mangkoran/lumberjack-keyboard/images/pcb-design.png

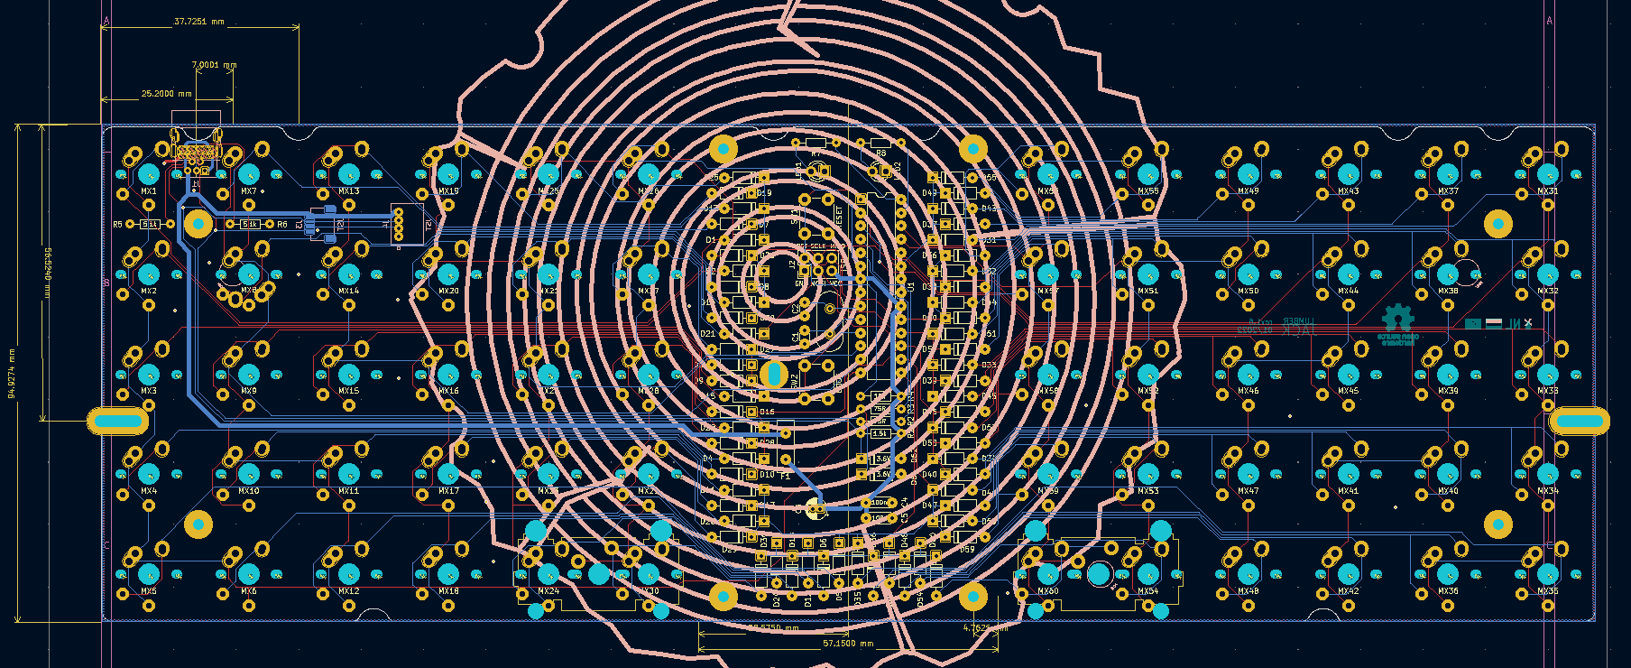
images/pcb-design.png
