mangkoran/lumberjack-keyboard/images/pcb-render.jpg

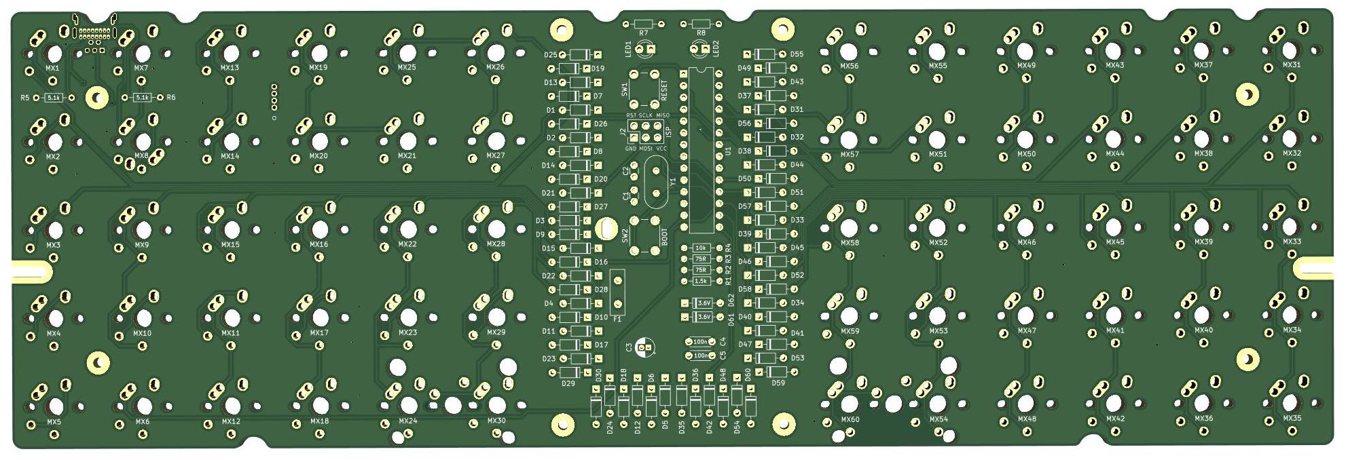
images/pcb-render.jpg
