mangkoran/lumberjack-keyboard/plates/lumberjack-brutal60-full.dxf

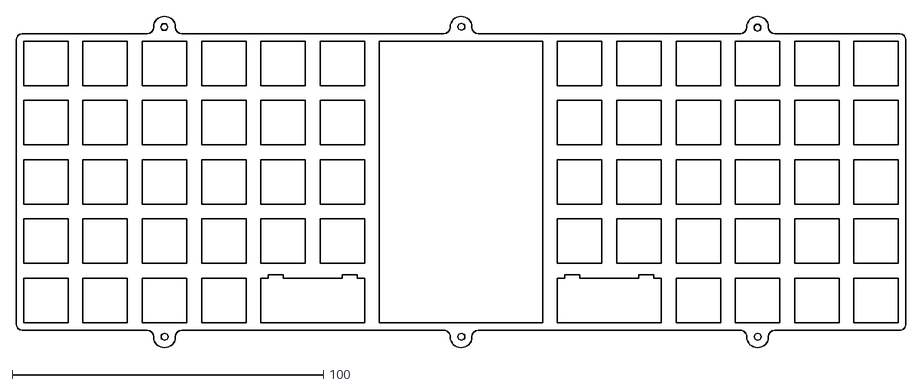
[picture p4: CAD file, 2022-01-30]
plates/lumberjack-brutal60-full.dxf
285.8 x 106.4
