mangkoran/lumberjack-keyboard/plates/lumberjack-full.dxf

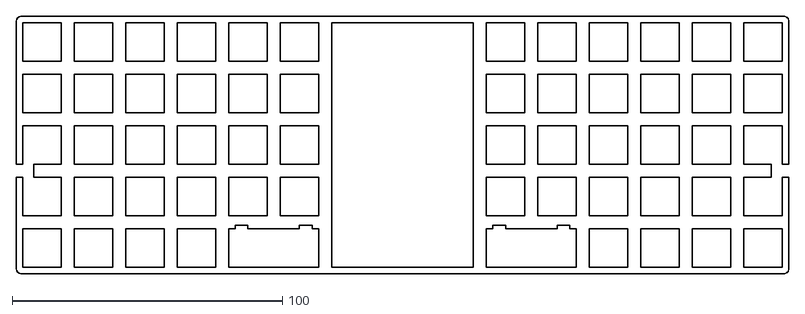
[picture p5: CAD file, 2022-01-30]
plates/lumberjack-full.dxf
285.8 x 95.3
