mangkoran/lumberjack-keyboard/plates/lumberjack-alps-full.dxf

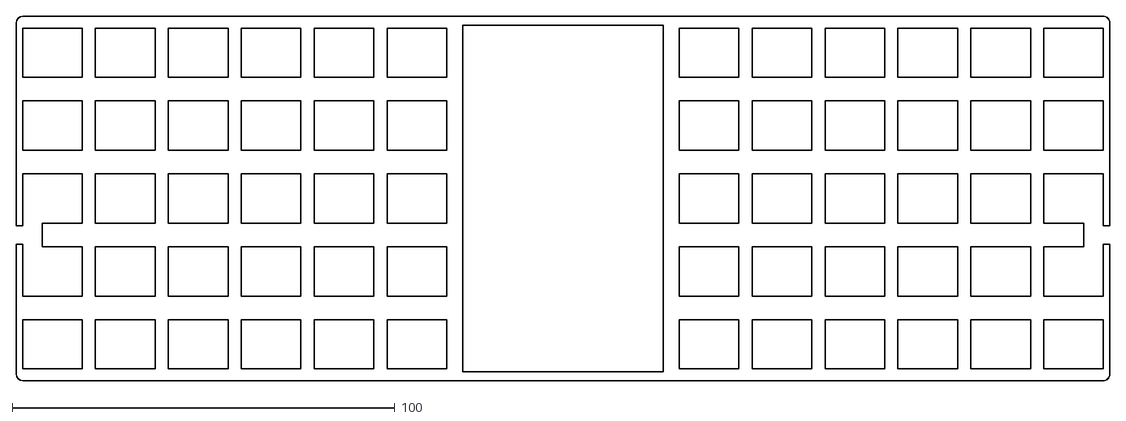
[picture p6: CAD file, 2022-01-30]
plates/lumberjack-alps-full.dxf
285.8 x 95.3
