mangkoran/lumberjack-keyboard/plates/lumberjack-polaris.dxf

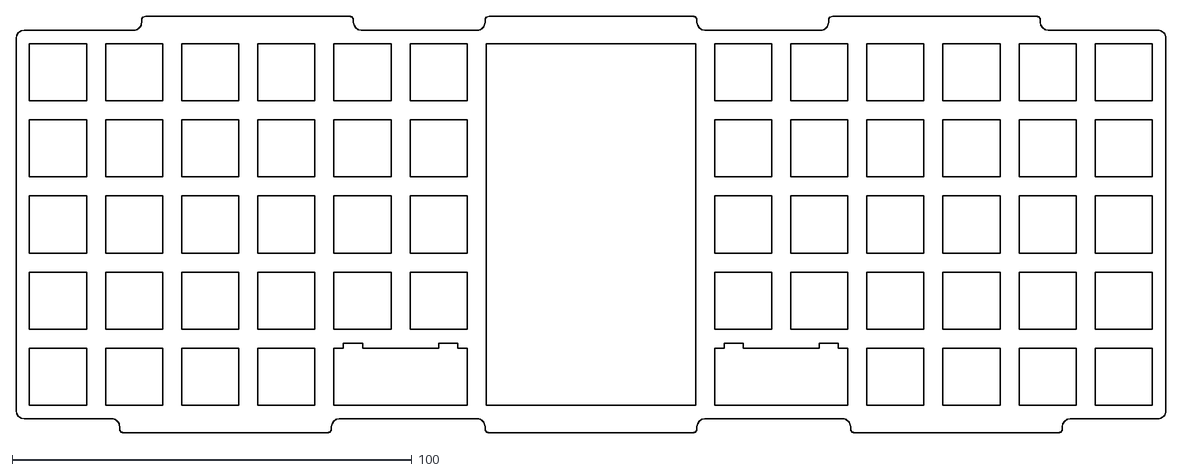
[picture p7: CAD file, 2022-01-30]
plates/lumberjack-polaris.dxf
287.7 x 104.2
