mangkoran/lumberjack-keyboard/plates/lumberjack-brutal60-split.dxf

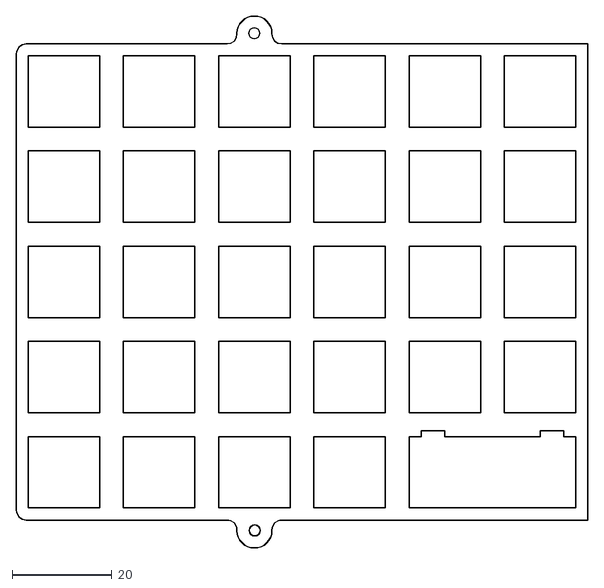
[picture p8: CAD file, 2022-01-30]
plates/lumberjack-brutal60-split.dxf
114.3 x 106.4
