mangkoran/lumberjack-keyboard/plates/lumberjack-alps-split.dxf

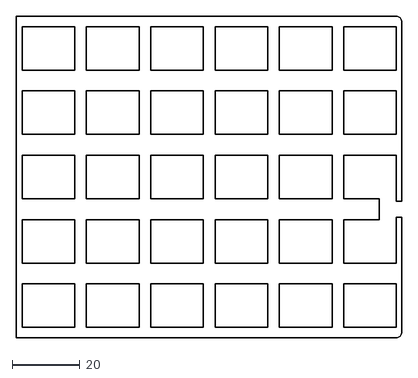
[picture p9: CAD file, 2022-01-18]
plates/lumberjack-alps-split.dxf
114.3 x 95.2
