mangkoran/lumberjack-keyboard/lumberjack.kicad_sch

## KiCad design lumberjack.kicad_sch (2022-02-06)

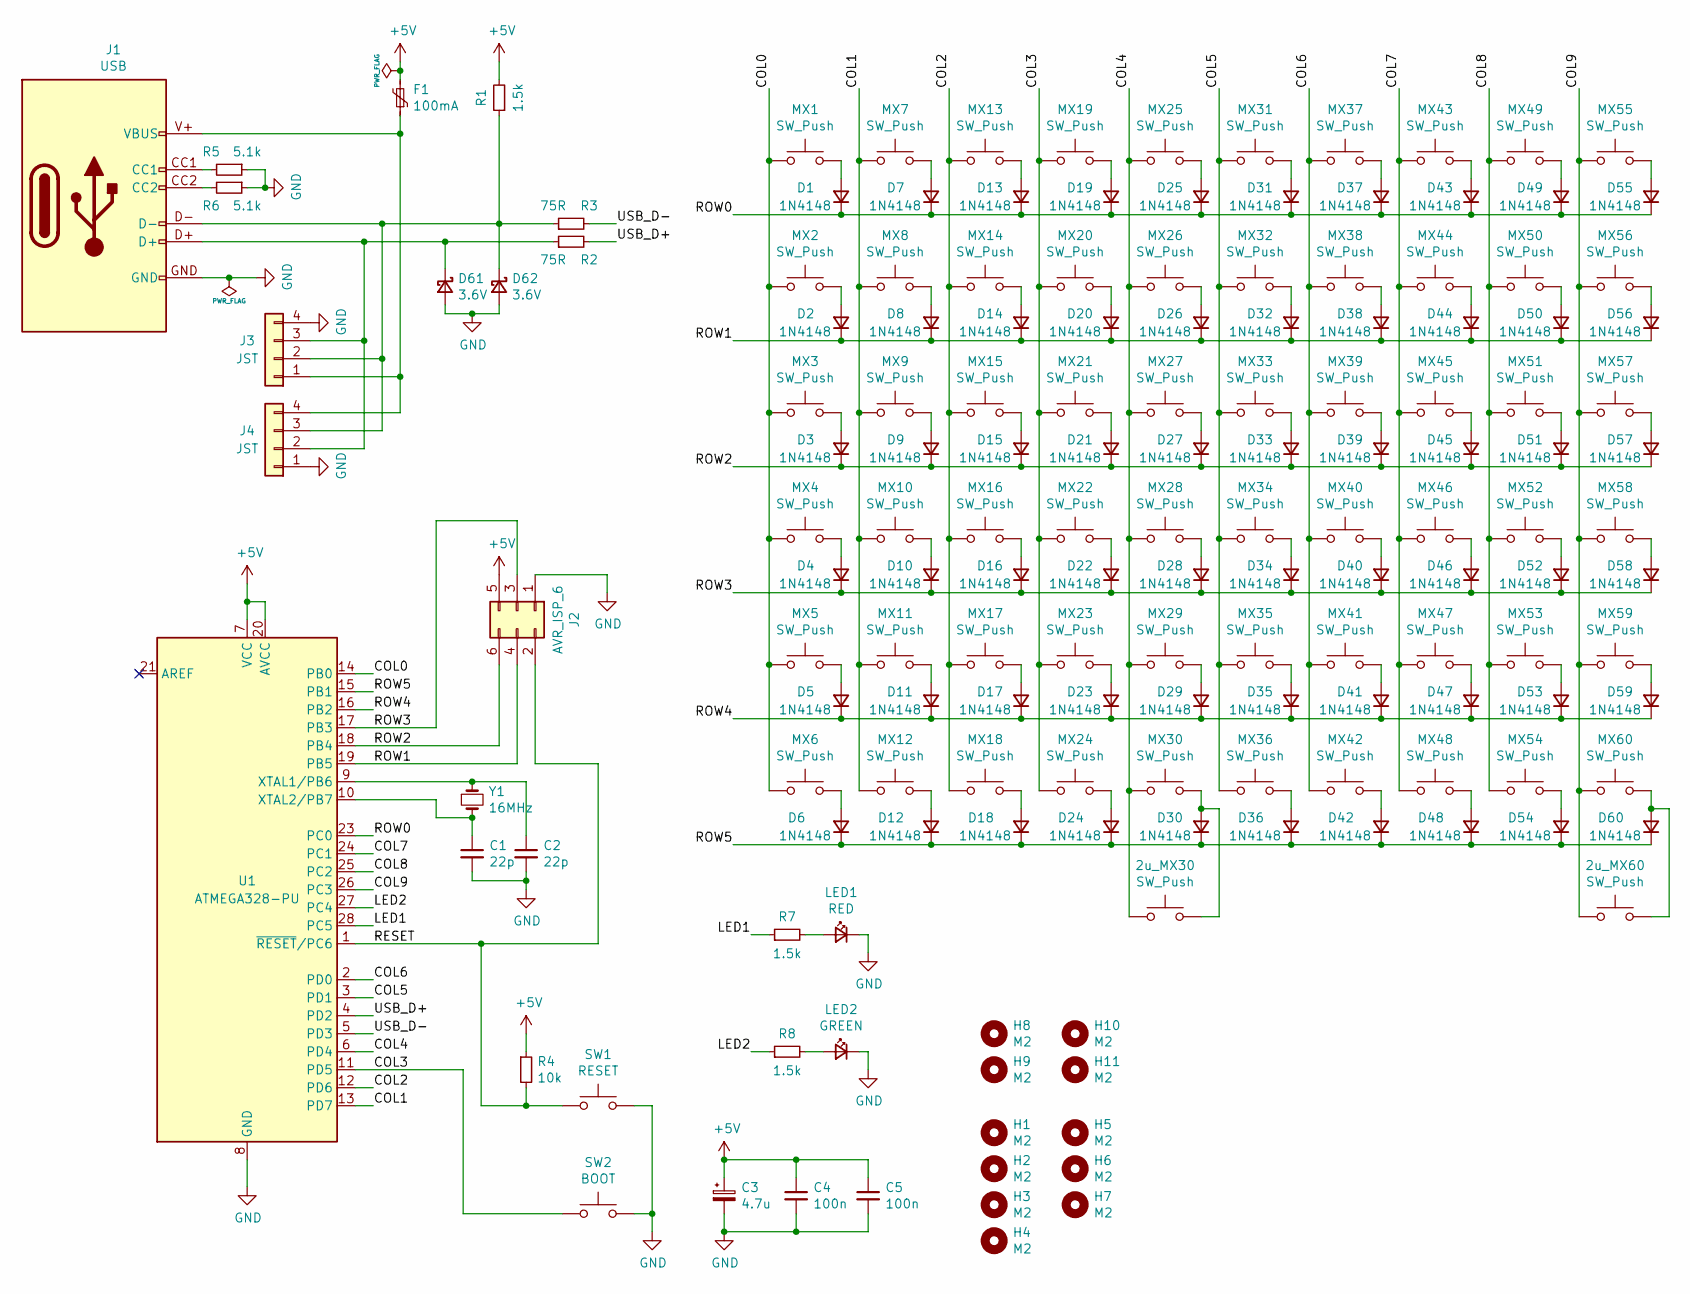
[picture p10: schematic lumberjack.kicad_sch]

Parts:
2u_MX30, 2u_MX60: SW_Push; MX_PCB_200B
C1, C2: 22p; C_Disc_D3.0mm_W1.6mm_P2.50mm
C3: 4.7u; CP_Radial_D4.0mm_P1.50mm
C4, C5: 100n; C_Disc_D4.3mm_W1.9mm_P5.00mm
D1, D2, D3, D4, D5, D6, D7, D8, D9, D10, D11, D12, D13, D14, D15, D16, D17, D18, D19, D20, D21, D22, D23, D24, D25, D26, D27, D28, D29, D30, D31, D32, D33, D34, D35, D36, D37, D38, D39, D40, D41, D42, D43, D44, D45, D46, D47, D48, D49, D50, D51, D52, D53, D54, D55, D56, D57, D58, D59, D60: 1N4148; D_DO-35_SOD27_P7.62mm_Horizontal
D61, D62: 3.6V; D_DO-35_SOD27_P7.62mm_Horizontal
F1: 100mA; Fuse_Bourns_MF-RHT100
H1, H2, H3, H4, H8, H9, H10, H11: M2; MountingHole_M2
H5, H6, H7: M2; MountingSlot_M2
J1: USB; USB_Hybrid_THT
J2: AVR_ISP_6; PinHeader_2x03_P2.54mm_Vertical
J3: JST; JST_SH_SM04B-SRSS-TB_1x04-1MP_P1.00mm_Horizontal
J4: JST; S4B-ZRLFSN
LED1: RED; LED_D3.0mm
LED2: GREEN; LED_D3.0mm
MX1, MX2, MX3, MX4, MX5, MX6, MX7, MX9, MX10, MX11, MX12, MX13, MX14, MX15, MX16, MX17, MX18, MX19, MX20, MX21, MX22, MX23, MX24, MX25, MX26, MX27, MX28, MX29, MX30, MX31, MX32, MX33, MX34, MX35, MX36, MX37, MX38, MX39, MX40, MX41, MX42, MX43, MX44, MX45, MX46, MX47, MX48, MX49, MX50, MX51, MX52, MX53, MX54, MX55, MX56, MX57, MX58, MX59, MX60: SW_Push; MX_Alps_Choc
MX8: SW_Push; MX_Alps_Choc_NTHSTH
R1, R7, R8: 1.5k; R_Axial_DIN0204_L3.6mm_D1.6mm_P7.62mm_Horizontal
R2, R3: 75R; R_Axial_DIN0204_L3.6mm_D1.6mm_P7.62mm_Horizontal
R4: 10k; R_Axial_DIN0204_L3.6mm_D1.6mm_P7.62mm_Horizontal
R5, R6: 5.1k; R_Axial_DIN0204_L3.6mm_D1.6mm_P7.62mm_Horizontal
SW1: RESET; SW_PUSH_6mm
SW2: BOOT; SW_PUSH_6mm
U1: ATMEGA328-PU; DIP-28_W7.62mm
Y1: 16MHz; Crystal_HC49-4H_Vertical

Connections:
+5V: C3.1, C4.1, C5.1, F1.2, J2.5, R1.2, R4.1, U1.7 (VCC), U1.20 (AVCC)
COL0: MX1.2, MX2.2, MX3.2, MX4.2, MX5.2, MX6.2, U1.14 (PB0)
COL1: MX7.2, MX8.2, MX9.2, MX10.2, MX11.2, MX12.2, U1.13 (PD7)
COL2: MX13.2, MX14.2, MX15.2, MX16.2, MX17.2, MX18.2, U1.12 (PD6)
COL3: MX19.2, MX20.2, MX21.2, MX22.2, MX23.2, MX24.2, SW2.1, U1.11 (PD5)
COL4: 2u_MX30.2, MX25.2, MX26.2, MX27.2, MX28.2, MX29.2, MX30.2, U1.6 (PD4)
COL5: MX31.2, MX32.2, MX33.2, MX34.2, MX35.2, MX36.2, U1.3 (PD1)
COL6: MX37.2, MX38.2, MX39.2, MX40.2, MX41.2, MX42.2, U1.2 (PD0)
COL7: MX43.2, MX44.2, MX45.2, MX46.2, MX47.2, MX48.2, U1.24 (PC1)
COL8: MX49.2, MX50.2, MX51.2, MX52.2, MX53.2, MX54.2, U1.25 (PC2)
COL9: 2u_MX60.2, MX55.2, MX56.2, MX57.2, MX58.2, MX59.2, MX60.2, U1.26 (PC3)
GND: C1.2, C2.2, C3.2, C4.2, C5.2, D61.2 (A), D62.2 (A), J1.GND, J2.1, J3.4, J4.1, LED1.1 (K), LED2.1 (K), R5.1, R6.1, SW1.2, SW2.2, U1.8 (GND), U1.22 (GND)
LED1: R7.1, U1.28 (PC5)
LED2: R8.1, U1.27 (PC4)
unnamed: 2u_MX30.1, D30.2 (A), MX30.1
unnamed: 2u_MX60.1, D60.2 (A), MX60.1
unnamed: C1.1, U1.10 (XTAL2/PB7), Y1.2
unnamed: C2.1, U1.9 (XTAL1/PB6), Y1.1
unnamed: D1.2 (A), MX1.1
unnamed: D2.2 (A), MX2.1
unnamed: D3.2 (A), MX3.1
unnamed: D4.2 (A), MX4.1
unnamed: D5.2 (A), MX5.1
unnamed: D6.2 (A), MX6.1
unnamed: D7.2 (A), MX7.1
unnamed: D8.2 (A), MX8.1
unnamed: D9.2 (A), MX9.1
unnamed: D10.2 (A), MX10.1
unnamed: D11.2 (A), MX11.1
unnamed: D12.2 (A), MX12.1
unnamed: D13.2 (A), MX13.1
unnamed: D14.2 (A), MX14.1
unnamed: D15.2 (A), MX15.1
unnamed: D16.2 (A), MX16.1
unnamed: D17.2 (A), MX17.1
unnamed: D18.2 (A), MX18.1
unnamed: D19.2 (A), MX19.1
unnamed: D20.2 (A), MX20.1
unnamed: D21.2 (A), MX21.1
unnamed: D22.2 (A), MX22.1
unnamed: D23.2 (A), MX23.1
unnamed: D24.2 (A), MX24.1
unnamed: D25.2 (A), MX25.1
unnamed: D26.2 (A), MX26.1
unnamed: D27.2 (A), MX27.1
unnamed: D28.2 (A), MX28.1
unnamed: D29.2 (A), MX29.1
unnamed: D31.2 (A), MX31.1
unnamed: D32.2 (A), MX32.1
unnamed: D33.2 (A), MX33.1
unnamed: D34.2 (A), MX34.1
unnamed: D35.2 (A), MX35.1
unnamed: D36.2 (A), MX36.1
unnamed: D37.2 (A), MX37.1
unnamed: D38.2 (A), MX38.1
unnamed: D39.2 (A), MX39.1
unnamed: D40.2 (A), MX40.1
unnamed: D41.2 (A), MX41.1
unnamed: D42.2 (A), MX42.1
unnamed: D43.2 (A), MX43.1
unnamed: D44.2 (A), MX44.1
unnamed: D45.2 (A), MX45.1
unnamed: D46.2 (A), MX46.1
unnamed: D47.2 (A), MX47.1
unnamed: D48.2 (A), MX48.1
unnamed: D49.2 (A), MX49.1
unnamed: D50.2 (A), MX50.1
unnamed: D51.2 (A), MX51.1
unnamed: D52.2 (A), MX52.1
unnamed: D53.2 (A), MX53.1
unnamed: D54.2 (A), MX54.1
unnamed: D55.2 (A), MX55.1
unnamed: D56.2 (A), MX56.1
unnamed: D57.2 (A), MX57.1
unnamed: D58.2 (A), MX58.1
unnamed: D59.2 (A), MX59.1
unnamed: D61.1 (K), J1.D+, J3.3, J4.2, R2.1
unnamed: D62.1 (K), J1.D-, J3.2, J4.3, R1.1, R3.1
unnamed: F1.1, J1.V+ (VBUS), J3.1, J4.4
unnamed: J1.CC1, R5.2
unnamed: J1.CC2, R6.2
unnamed: LED1.2 (A), R7.2
unnamed: LED2.2 (A), R8.2
RESET: J2.2, R4.2, SW1.1, U1.1 (~RESET/PC6)
ROW0: D1.1 (K), D7.1 (K), D13.1 (K), D19.1 (K), D25.1 (K), D31.1 (K), D37.1 (K), D43.1 (K), D49.1 (K), D55.1 (K), U1.23 (PC0)
ROW1: D2.1 (K), D8.1 (K), D14.1 (K), D20.1 (K), D26.1 (K), D32.1 (K), D38.1 (K), D44.1 (K), D50.1 (K), D56.1 (K), J2.4, U1.19 (PB5)
ROW2: D3.1 (K), D9.1 (K), D15.1 (K), D21.1 (K), D27.1 (K), D33.1 (K), D39.1 (K), D45.1 (K), D51.1 (K), D57.1 (K), J2.6, U1.18 (PB4)
ROW3: D4.1 (K), D10.1 (K), D16.1 (K), D22.1 (K), D28.1 (K), D34.1 (K), D40.1 (K), D46.1 (K), D52.1 (K), D58.1 (K), J2.3, U1.17 (PB3)
ROW4: D5.1 (K), D11.1 (K), D17.1 (K), D23.1 (K), D29.1 (K), D35.1 (K), D41.1 (K), D47.1 (K), D53.1 (K), D59.1 (K), U1.16 (PB2)
ROW5: D6.1 (K), D12.1 (K), D18.1 (K), D24.1 (K), D30.1 (K), D36.1 (K), D42.1 (K), D48.1 (K), D54.1 (K), D60.1 (K), U1.15 (PB1)
USB_D+: R2.2, U1.4 (PD2)
USB_D-: R3.2, U1.5 (PD3)
