mangkoran/lumberjack-keyboard/(commit log)

2022-01-15 Update split plate project to KiCad 6
    [lumberjack-split-B_Cu.gbl, lumberjack-split-B_Mask.gbs, lumberjack-split-B_Paste.gbp, lumberjack-split-B_Silkscreen.gbo, lumberjack-split-Edge_Cuts.gm1, lumberjack-split-F_Cu.gtl, lumberjack-split-F_Mask.gts, lumberjack-split-F_Silkscreen.gto]
2022-01-15 Remove extra support pin from Choc footprint
2022-01-18 Add FR4 plate with Alps mount holes
    [lumberjack-alps-B_Cu.gbl, lumberjack-alps-B_Mask.gbs, lumberjack-alps-B_Paste.gbp, lumberjack-alps-B_Silkscreen.gbo, lumberjack-alps-Edge_Cuts.gm1, lumberjack-alps-F_Cu.gtl, lumberjack-alps-F_Mask.gts, lumberjack-alps-F_Paste.gtp]
2022-01-18 Revert to more spacious hybrid USB design
    [lumberjack-B_Cu.gbr, lumberjack-B_Mask.gbr, lumberjack-B_Paste.gbr, lumberjack-B_Silkscreen.gbr, lumberjack-Edge_Cuts.gbr, lumberjack-F_Cu.gbr, lumberjack-F_Mask.gbr, lumberjack-F_Paste.gbr]
2022-01-19 Move switch silkscreen to top of PCB
    [lumberjack-B_Cu.gbr, lumberjack-B_Mask.gbr, lumberjack-B_Paste.gbr, lumberjack-B_Silkscreen.gbr, lumberjack-Edge_Cuts.gbr, lumberjack-F_Cu.gbr, lumberjack-F_Mask.gbr, lumberjack-F_Paste.gbr]
2022-01-21 Add information to guide about using tall capacitors
2022-01-29 Enlarge full plate center cutout
    [lumberjack-full-B_Cu.gbl, lumberjack-full-B_Mask.gbs, lumberjack-full-B_Paste.gbp, lumberjack-full-B_Silkscreen.gbo, lumberjack-full-Edge_Cuts.gm1, lumberjack-full-F_Cu.gtl, lumberjack-full-F_Mask.gts, lumberjack-full-F_Silkscreen.gto]
2022-01-30 Add full Alps plate
    [lumberjack-alps-full-B_Cu.gbl, lumberjack-alps-full-B_Mask.gbs, lumberjack-alps-full-B_Paste.gbp, lumberjack-alps-full-B_Silkscreen.gbo, lumberjack-alps-full-Edge_Cuts.gm1, lumberjack-alps-full-F_Cu.gtl, lumberjack-alps-full-F_Mask.gts, lumberjack-alps-full-F_Paste.gtp]
2022-01-30 Add DXF plot for full plate
    [lumberjack-full.dxf]
2022-01-30 Update Brutal60 plates to KiCad6
    [brutal60-full.kicad_pcb, brutal60-split.kicad_pcb, lumberjack-brutal60-full.dxf, lumberjack-brutal60-split.dxf]
2022-01-30 Reorganise plate files
    [lumberjack-alps-full.kicad_pcb, lumberjack-alps-split.dxf, lumberjack-alps-split.kicad_pcb, lumberjack-full.kicad_pcb, lumberjack-split.kicad_pcb]
2022-01-30 Update Brutal60 plate gerbers
    [brutal60-full-B_Cu.gbl, brutal60-full-B_Mask.gbs, brutal60-full-B_Paste.gbp, brutal60-full-B_Silkscreen.gbo, brutal60-full-Edge_Cuts.gm1, brutal60-full-F_Cu.gtl, brutal60-full-F_Mask.gts, brutal60-full-F_Paste.gtp]
2022-01-30 Add plate for Polaris
    [lumberjack-polaris.dxf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]
2022-02-02 Increase route clearance from drilled holes
    [lumberjack-B_Cu.gbr, lumberjack-B_Mask.gbr, lumberjack-B_Paste.gbr, lumberjack-B_Silkscreen.gbr, lumberjack-Edge_Cuts.gbr, lumberjack-F_Cu.gbr, lumberjack-F_Mask.gbr, lumberjack-F_Paste.gbr]
2022-02-06 Add extra standoff mounting holes
    [lumberjack-B_Cu.gbr, lumberjack-B_Mask.gbr, lumberjack-B_Paste.gbr, lumberjack-B_Silkscreen.gbr, lumberjack-Edge_Cuts.gbr, lumberjack-F_Cu.gbr, lumberjack-F_Mask.gbr, lumberjack-F_Paste.gbr]
2022-02-06 Update PCB rendering
